Joey9801/Lynx/README

Lynx is an experimental radio transmitter for HAB's
