Joey9801/Lynx/Lynx PCB r1/Lynx.brd

## EAGLE design Lynx PCB r1/Lynx.brd (2013-07-16)

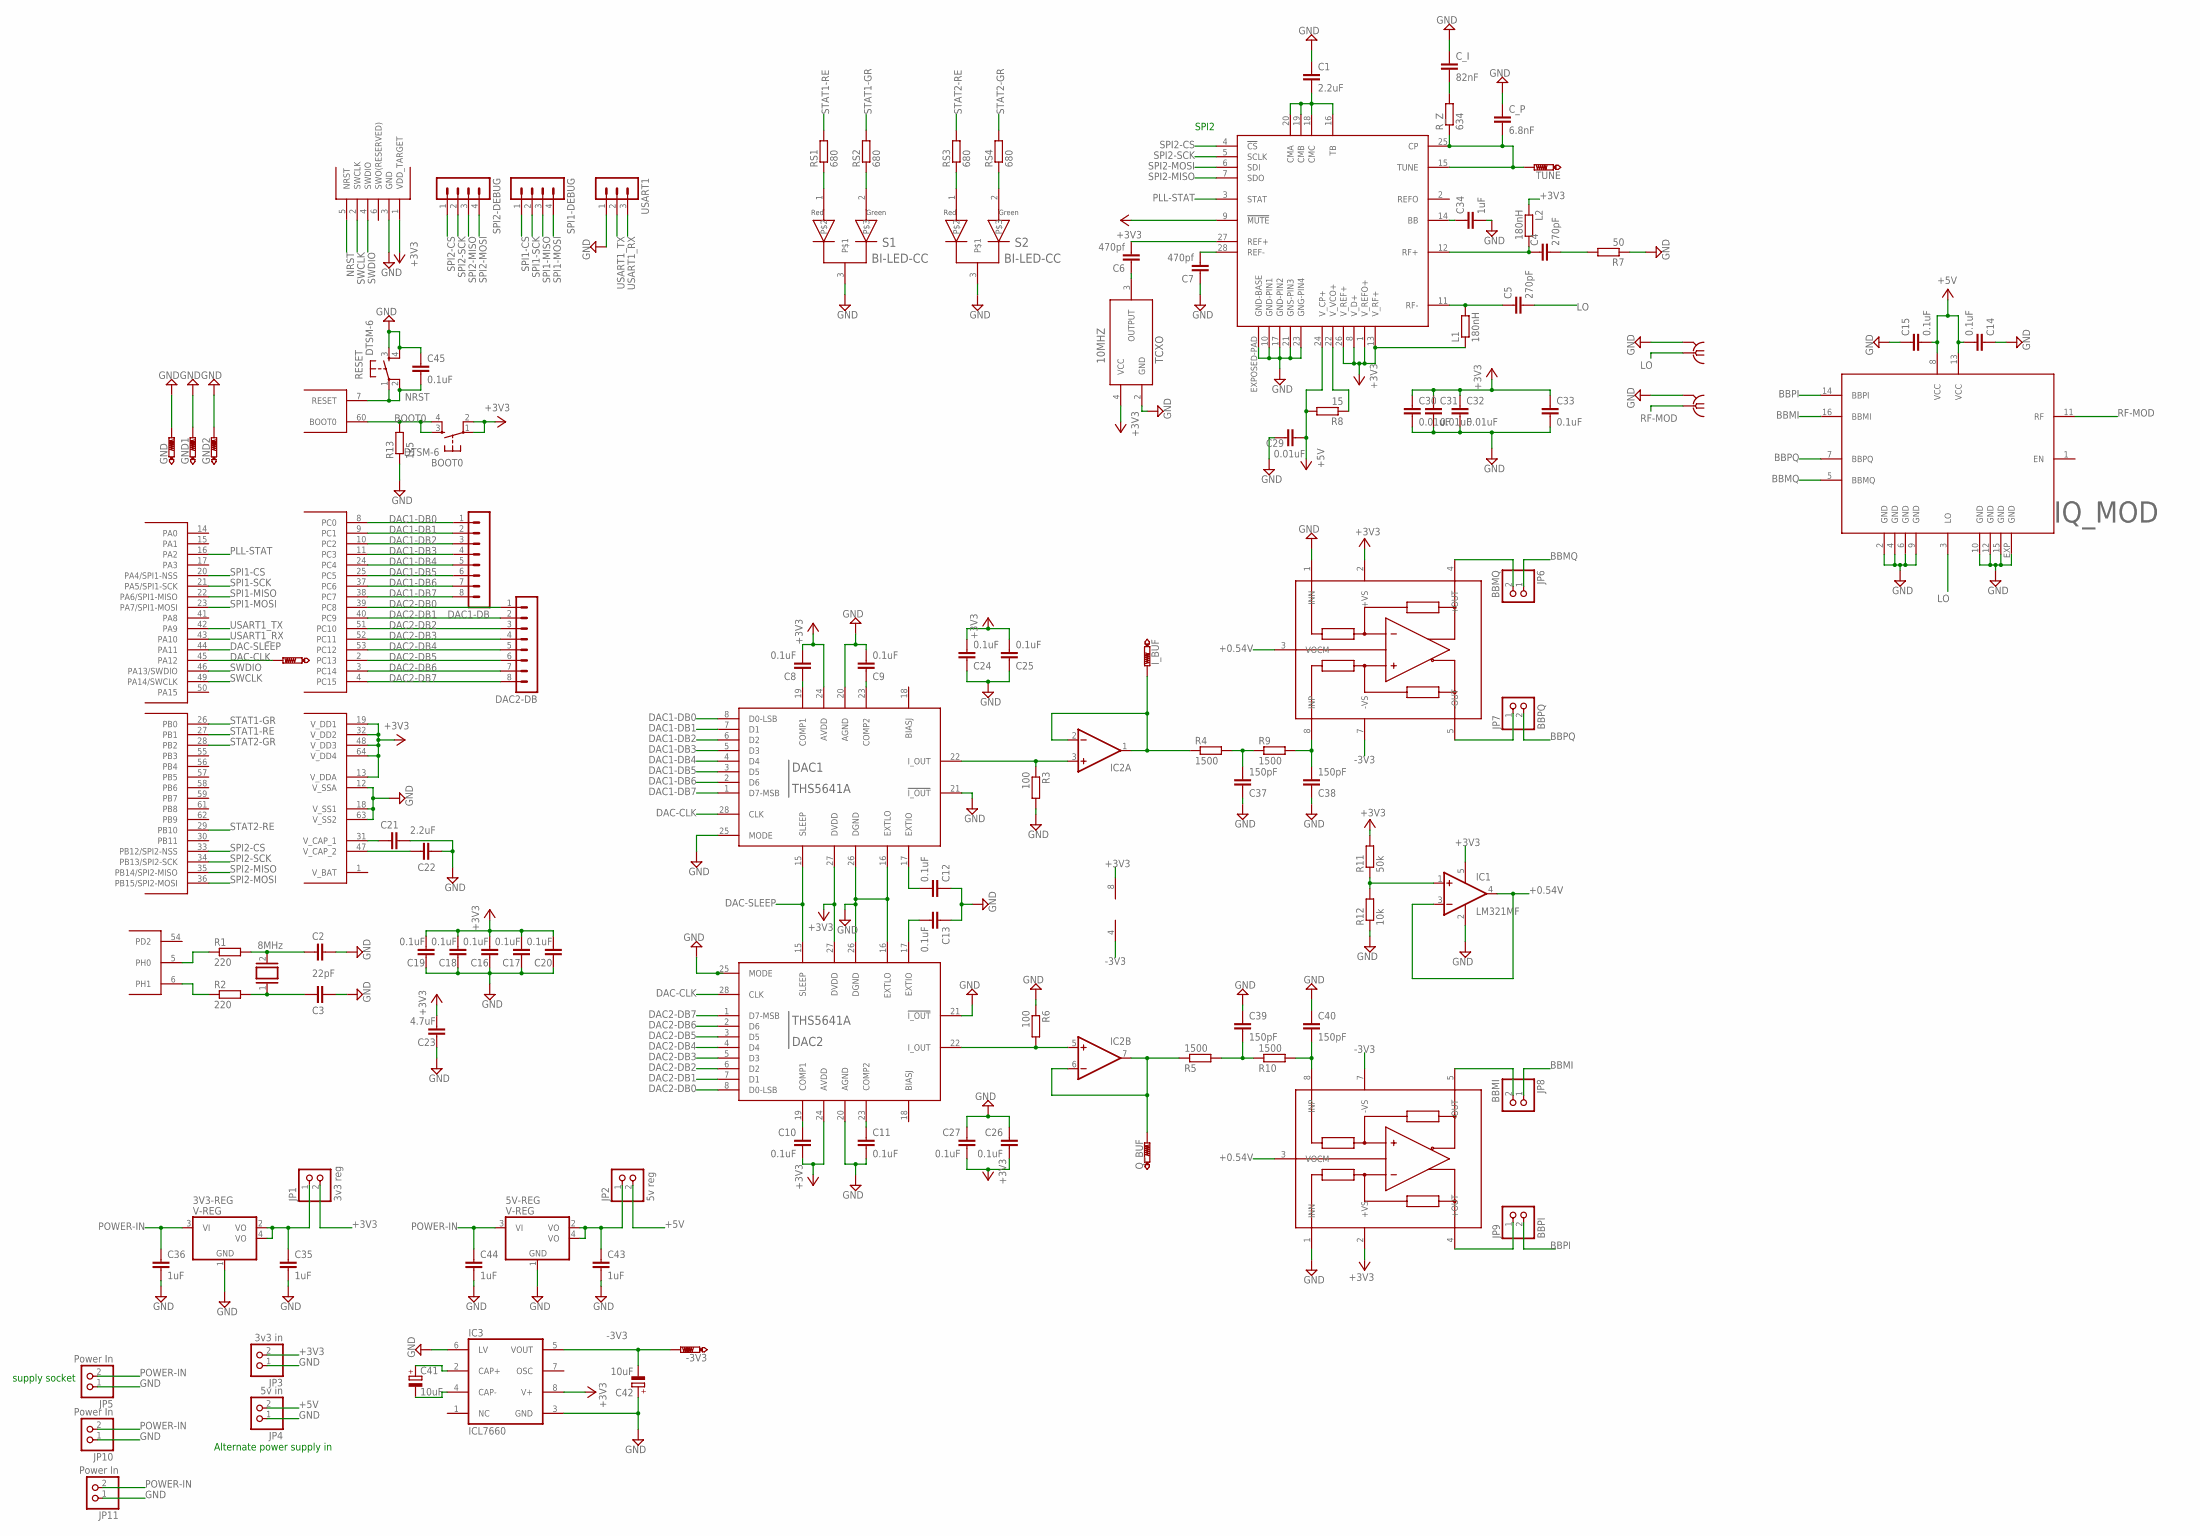
[picture p1: schematic Lynx.sch]

Parts:
3V3-REG, 5V-REG: V-REG; SOT223
10MHZ: TCXO; TXCO5.6
-3V3: PTR1PAD1-13Y; P1-13Y
BOOT0: DTSM-6
C1, C21, C22: 2.2uF; C0603
C2, C3: 22pF; C0603
C4, C5: 270pF; C0805
C6, C7: 470pf; C0402
C8, C9, C10, C11, C12, C13, C14, C15, C16, C17, C18, C19, C20, C24, C25, C26, C27, C33, C45: 0.1uF; C0603
C23: 4.7uF; C0603
C29, C30, C32: 0.01uF; C0603
C31: 0.01uF; C0402
C34, C35, C36, C43, C44: 1uF; C0603
C37, C38, C39, C40: 150pF; C0603
C41, C42: 10uF; SANYO-OSCON_SMD_B6
C_I: 82nF; C1210
C_P: 6.8nF; C0805
DAC1, DAC2: THS5641A; SO28
DAC1-DB, DAC2-DB: MA08-1
DAC-CLK: PTR1PAD1-13Y; P1-13Y
GND, GND1, GND2: PTR1PAD1-13Y; P1-13Y
IC1: LM321MF; SOT23-5
IC2: 2AMP_P8+4D; SO08
IC3: ICL7660; SO08
IQ_MOD: LT5568; QFN-16
I_BUF: PTR1PAD1-13Y; P1-13Y
JP1: 3v3 reg; 1X02
JP2: 5v reg; 1X02
JP3: 3v3 in; 1X02
JP4: 5v in; 1X02
JP5, JP10, JP11: Power In; 1X02
JP6: BBMQ; 1X02
JP7: BBPQ; 1X02
JP8: BBMI; 1X02
JP9: BBPI; 1X02
L1, L2: 180nH; R0402
LO: SMA-142-0711-821/826; J502-ND-142-0711-821/826
Q1: 8MHz; QS
Q_BUF: PTR1PAD1-13Y; P1-13Y
R1, R2: 220; R0603
R3, R6: 100; R0603
R4, R5, R9, R10: 1500; R0603
R7: 50; R0805
R8: 15; R0603
R11: 50k; R0603
R12: 10k; R0603
R13: 1k5; R0603
RESET: DTSM-6
RF-MOD: SMA-142-0711-821/826; J502-ND-142-0711-821/826
RS1, RS2, RS3, RS4: 680; R0603
R_Z: 634; R0805
S1, S2: BI-LED-CC; SOT-23
SPI1-DEBUG, SPI2-DEBUG: MA04-1
SWD-HEADER: SWD-HEADER; 6PIN-HEADER
TUNE: PTR1B1,27; B1,27
U$1: STM32F415RGT6; LQFP-64
U$3: LTC6946; QFN-28
U$4, U$5: AD8476; MSOP8
USART1: MA03-1

Connections:
5V-REG: 5V-REG.2 (VO), 5V-REG.4 (VO), C43.1, JP2.1
+0.54V: IC1.3 (-IN), IC1.4 (OUT), U$4.3 (VOCM), U$5.3 (VOCM)
+3V3: 10MHZ.4 (VCC), BOOT0.1, BOOT0.2, C8.2, C10.2, C16.2, C17.2, C18.2, C19.2, C20.2, C23.2, C24.2, C25.2, C26.2, C27.2, C30.1, C31.1, C32.1, C33.1, DAC1.24 (AVDD), DAC1.27 (DVDD), DAC2.24 (AVDD), DAC2.27 (DVDD), IC1.5 (V+), IC2.8 (V+), IC3.8 (V+), JP1.2, JP3.2, L1.1, L2.1, R11.2, SWD-HEADER.1 (VDD_TARGET), U$1.13 (V_DDA), U$1.19 (V_DD1), U$1.32 (V_DD2), U$1.48 (V_DD3), U$1.64 (V_DD4), U$3.1 (V_REFO+), U$3.8 (V_D+), U$3.9 (!MUTE!), U$3.13 (V_RF+), U$3.26 (V_REF+), U$4.2 (+VS), U$5.2 (+VS)
+5V: C14.2, C15.2, C29.2, IQ_MOD.8 (VCC), IQ_MOD.13 (VCC), JP2.2, JP4.2, R8.2, U$3.24 (V_CP+)
-3V3: -3V3.TP, C42.-, IC2.4 (V-), IC3.5 (VOUT), U$4.7 (-VS), U$5.7 (-VS)
BBMI: IQ_MOD.16 (BBMI), JP8.1
BBMQ: IQ_MOD.5 (BBMQ), JP6.1
BBPI: IQ_MOD.14 (BBPI), JP9.2
BBPQ: IQ_MOD.7 (BBPQ), JP7.2
BOOT0: BOOT0.3, BOOT0.4, R13.2, U$1.60 (BOOT0)
DAC1-DB0: DAC1.8 (D0-LSB), DAC1-DB.1, U$1.8 (PC0)
DAC1-DB1: DAC1.7 (D1), DAC1-DB.2, U$1.9 (PC1)
DAC1-DB2: DAC1.6 (D2), DAC1-DB.3, U$1.10 (PC2)
DAC1-DB3: DAC1.5 (D3), DAC1-DB.4, U$1.11 (PC3)
DAC1-DB4: DAC1.4 (D4), DAC1-DB.5, U$1.24 (PC4)
DAC1-DB5: DAC1.3 (D5), DAC1-DB.6, U$1.25 (PC5)
DAC1-DB6: DAC1.2 (D6), DAC1-DB.7, U$1.37 (PC6)
DAC1-DB7: DAC1.1 (D7-MSB), DAC1-DB.8, U$1.38 (PC7)
DAC2-DB0: DAC2.8 (D0-LSB), DAC2-DB.1, U$1.39 (PC8)
DAC2-DB1: DAC2.7 (D1), DAC2-DB.2, U$1.40 (PC9)
DAC2-DB2: DAC2.6 (D2), DAC2-DB.3, U$1.51 (PC10)
DAC2-DB3: DAC2.5 (D3), DAC2-DB.4, U$1.52 (PC11)
DAC2-DB4: DAC2.4 (D4), DAC2-DB.5, U$1.53 (PC12)
DAC2-DB5: DAC2.3 (D5), DAC2-DB.6, U$1.2 (PC13)
DAC2-DB6: DAC2.2 (D6), DAC2-DB.7, U$1.3 (PC14)
DAC2-DB7: DAC2.1 (D7-MSB), DAC2-DB.8, U$1.4 (PC15)
DAC-CLK: DAC1.28 (CLK), DAC2.28 (CLK), DAC-CLK.TP, U$1.45 (PA12)
DAC-SLEEP: DAC1.15 (SLEEP), DAC2.15 (SLEEP), U$1.44 (PA11)
GND: 3V3-REG.1 (GND), 5V-REG.1 (GND), 10MHZ.2 (GND), C1.1, C2.2, C3.2, C7.1, C9.2, C11.2, C12.1, C13.1, C14.1, C15.1, C16.1, C17.1, C18.1, C19.1, C20.1, C21.2, C22.2, C23.1, C24.1, C25.1, C26.1, C27.1, C29.1, C30.2, C31.2, C32.2, C33.2, C34.2, C35.2, C36.2, C37.1, C38.1, C39.1, C40.1, C42.+, C43.2, C44.2, C45.1, C_I.1, C_P.1, DAC1.16 (EXTLO), DAC1.20 (AGND), DAC1.21 (!I_OUT!), DAC1.25 (MODE), DAC1.26 (DGND), DAC2.16 (EXTLO), DAC2.20 (AGND), DAC2.21 (!I_OUT!), DAC2.25 (MODE), DAC2.26 (DGND), GND.TP, GND1.TP, GND2.TP, IC1.2 (V-), IC3.3 (GND), IC3.6 (LV), IQ_MOD.2 (GND), IQ_MOD.4 (GND), IQ_MOD.6 (GND), IQ_MOD.9 (GND), IQ_MOD.10 (GND), IQ_MOD.12 (GND), IQ_MOD.15 (GND), IQ_MOD.EXP (GND), JP3.1, JP4.1, JP5.1, JP10.1, JP11.1, LO.G@1 (2), LO.G@2 (2), LO.G@3 (2), LO.G@4 (2), R3.2, R6.1, R7.1, R12.1, R13.1, RESET.3, RESET.4, RF-MOD.G@1 (2), RF-MOD.G@2 (2), RF-MOD.G@3 (2), RF-MOD.G@4 (2), S1.3, S2.3, SWD-HEADER.3 (GND), U$1.12 (V_SSA), U$1.18 (V_SS1), U$1.63 (V_SS2), U$3.10 (GND-PIN1), U$3.17 (GND-PIN2), U$3.21 (GNS-PIN3), U$3.23 (GNG-PIN4), U$3.EXPOSED-PAD (GND-BASE), U$4.1 (INN), U$5.1 (INN), USART1.1
I_BUF: IC2.1 (OUT), IC2.2 (-IN), I_BUF.TP, R4.1
LO: C5.2, IQ_MOD.3 (LO), LO.1
unnamed: C_P.2, R_Z.1, TUNE.TP, U$3.15 (TUNE), U$3.25 (CP)
unnamed: C1.2, U$3.16 (TB), U$3.18 (CMC), U$3.19 (CMB), U$3.20 (CMA)
unnamed: C7.2, U$3.28 (REF-)
unnamed: C3.1, Q1.1, R2.2
unnamed: C2.1, Q1.2, R1.2
unnamed: R1.1, U$1.5 (PH0)
unnamed: R2.1, U$1.6 (PH1)
unnamed: C5.1, L1.2, U$3.11 (RF-)
unnamed: C4.2, R7.2
unnamed: C13.2, DAC2.17 (EXTIO)
unnamed: C8.1, DAC1.19 (COMP1)
unnamed: C12.2, DAC1.17 (EXTIO)
unnamed: DAC1.22 (I_OUT), IC2.3 (+IN), R3.1
unnamed: JP6.2, U$4.4 (+OUT)
unnamed: RS1.1, S1.1
unnamed: RS2.1, S1.2
unnamed: RS3.1, S2.1
unnamed: RS4.1, S2.2
unnamed: C10.1, DAC2.19 (COMP1)
unnamed: C6.2, U$3.27 (REF+)
unnamed: 10MHZ.3 (OUTPUT), C6.1
unnamed: C_I.2, R_Z.2
unnamed: C9.1, DAC1.23 (COMP2)
unnamed: C11.1, DAC2.23 (COMP2)
unnamed: C21.1, U$1.31 (V_CAP_1)
unnamed: C22.1, U$1.47 (V_CAP_2)
unnamed: JP7.1, U$4.5 (-OUT)
unnamed: DAC2.22 (I_OUT), IC2.5 (+IN), R6.2
unnamed: R8.1, U$3.22 (V_VCO+)
unnamed: C37.2, R4.2, R9.1
unnamed: C38.2, R9.2, U$4.8 (INP)
unnamed: C34.1, U$3.14 (BB)
unnamed: C41.-, IC3.4 (CAP-)
unnamed: C39.2, R5.2, R10.1
unnamed: C40.2, R10.2, U$5.8 (INP)
unnamed: C41.+, IC3.2 (CAP+)
unnamed: 3V3-REG.2 (VO), 3V3-REG.4 (VO), C35.1, JP1.1
unnamed: JP8.2, U$5.5 (-OUT)
unnamed: JP9.1, U$5.4 (+OUT)
unnamed: IC1.1 (+IN), R11.1, R12.2
NRST: C45.2, RESET.1, RESET.2, SWD-HEADER.5 (NRST), U$1.7 (RESET)
PLL-STAT: U$1.16 (PA2), U$3.3 (STAT)
POWER-IN: 3V3-REG.3 (VI), 5V-REG.3 (VI), C36.1, C44.1, JP5.2, JP10.2, JP11.2
Q_BUF: IC2.6 (-IN), IC2.7 (OUT), Q_BUF.TP, R5.1
RF+: C4.1, L2.2, U$3.12 (RF+)
RF-MOD: IQ_MOD.11 (RF), RF-MOD.1
SPI1-CS: SPI1-DEBUG.1, U$1.20 (PA4/SPI1-NSS)
SPI1-MISO: SPI1-DEBUG.3, U$1.22 (PA6/SPI1-MISO)
SPI1-MOSI: SPI1-DEBUG.4, U$1.23 (PA7/SPI1-MOSI)
SPI1-SCK: SPI1-DEBUG.2, U$1.21 (PA5/SPI1-SCK)
SPI2-CS: SPI2-DEBUG.1, U$1.33 (PB12/SPI2-NSS), U$3.4 (!CS!)
SPI2-MISO: SPI2-DEBUG.3, U$1.35 (PB14/SPI2-MISO), U$3.7 (SDO)
SPI2-MOSI: SPI2-DEBUG.4, U$1.36 (PB15/SPI2-MOSI), U$3.6 (SDI)
SPI2-SCK: SPI2-DEBUG.2, U$1.34 (PB13/SPI2-SCK), U$3.5 (SCLK)
STAT1-GR: RS2.2, U$1.26 (PB0)
STAT1-RE: RS1.2, U$1.27 (PB1)
STAT2-GR: RS4.2, U$1.28 (PB2)
STAT2-RE: RS3.2, U$1.29 (PB10)
SWCLK: SWD-HEADER.2 (SWCLK), U$1.49 (PA14/SWCLK)
SWDIO: SWD-HEADER.4 (SWDIO), U$1.46 (PA13/SWDIO)
USART1_RX: U$1.43 (PA10), USART1.3
USART1_TX: U$1.42 (PA9), USART1.2

Notes on the sheet:
Alternate power supply in
supply socket
SPI2

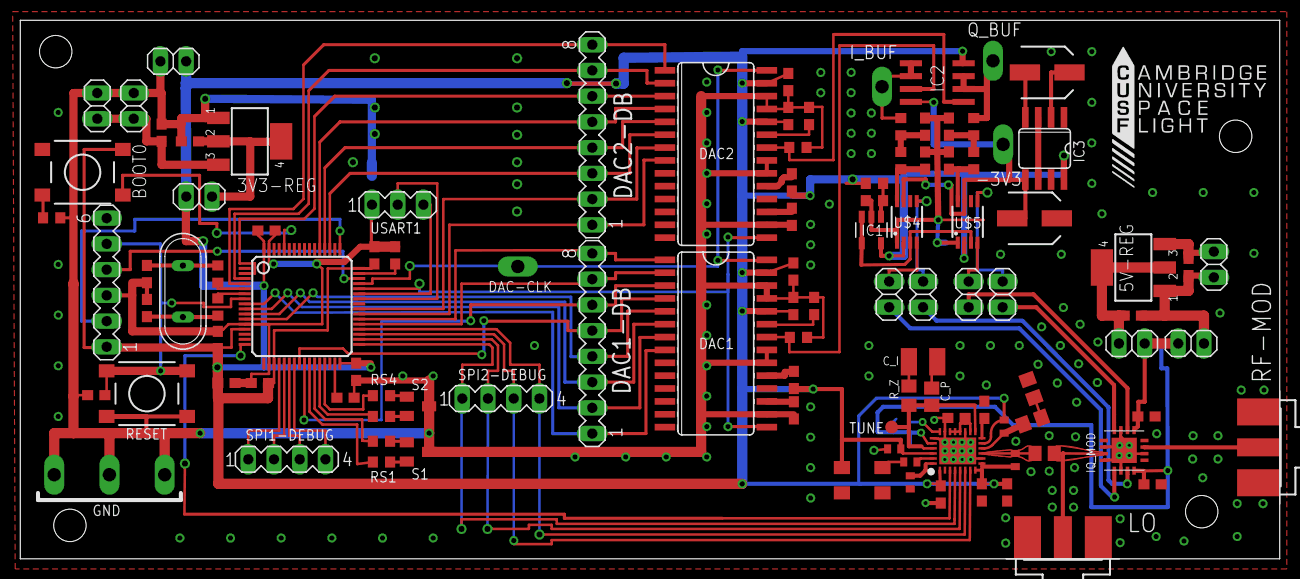
[picture p2: board Lynx.brd from above]

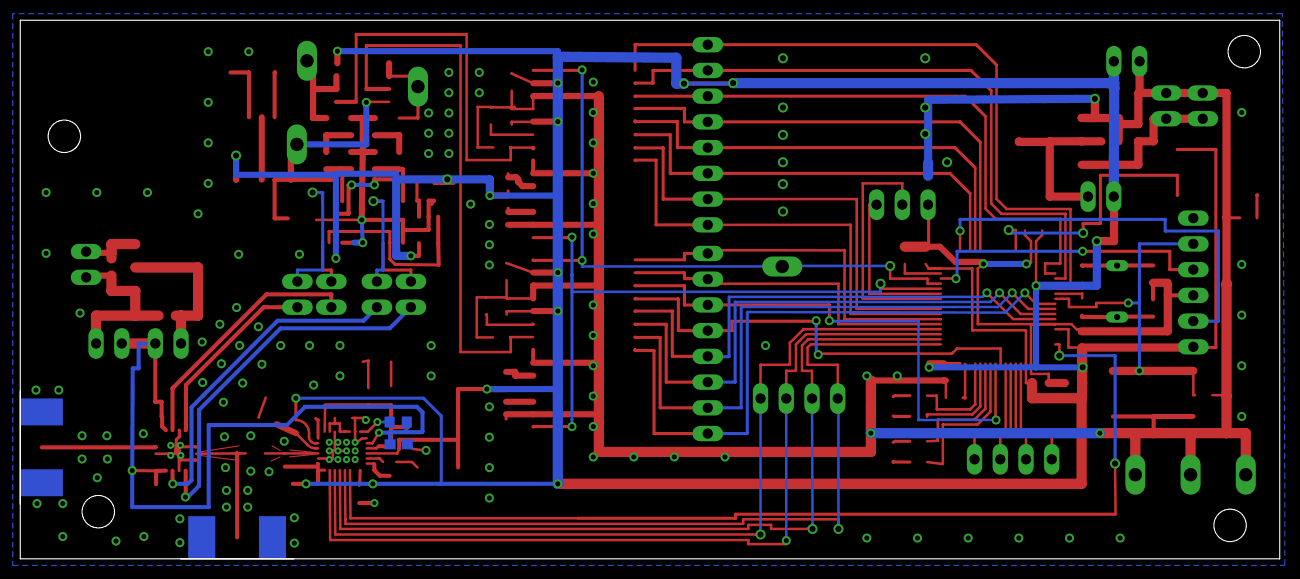
[picture p3: board Lynx.brd from below]

Board: 2 copper layers, 124.3 x 53.1 mm, 112 parts (2 on the bottom side), 93 nets.

Other parts of the board:
U$2: CUSF_LOGO
