Joey9801/Lynx/playground/init.c

#include "init.h"

static void clock_setup(void){
	/*Operate at 168MHz*/
	rcc_clock_setup_hse_3v3(&hse_8mhz_3v3[CLOCK_3V3_168MHZ]);

	//usart2
	rcc_peripheral_enable_clock(&RCC_APB1ENR, RCC_APB1ENR_USART2EN);

	//usart port
	rcc_peripheral_enable_clock(&RCC_AHB1ENR, RCC_AHB1ENR_IOPAEN);

	//led port
	rcc_peripheral_enable_clock(&RCC_AHB1ENR, RCC_AHB1ENR_IOPDEN);

	//SPI1
	rcc_peripheral_enable_clock(&RCC_APB2ENR, RCC_APB2ENR_SPI1EN);
	
	//SPI1 port
	rcc_peripheral_enable_clock(&RCC_AHB1ENR, RCC_AHB1ENR_IOPAEN);

	//Accelerometer CS port
	rcc_peripheral_enable_clock(&RCC_AHB1ENR, RCC_AHB1ENR_IOPEEN);
}

static void usart_setup(void){
	/* set the baudrate
	set the data and stop bits
	set the mode (tx/rx etc)
	set parity bits
	set flow control - may not apply for uart
	enable the thing */

	//usart pins
	gpio_mode_setup(GPIOA, GPIO_MODE_AF, GPIO_PUPD_NONE,
						GPIO2|
						GPIO3);
	gpio_set_af(GPIOA, GPIO_AF7,		GPIO2|
						GPIO3);

	usart_set_baudrate(USART2, 38400);
	usart_set_databits(USART2, 8);
	usart_set_stopbits(USART2, USART_STOPBITS_1);
	usart_set_mode(USART2, USART_MODE_TX);
	usart_set_parity(USART2, USART_PARITY_NONE);
	usart_set_flow_control(USART2, USART_FLOWCONTROL_NONE);

	usart_enable(USART2);
}


static void spi_setup(void){

//PA5 -> SPI1 SCK
//PA6 -> SPI1 MISO
//PA7 -> SPI1 MOSI
//PE3 -> Accel CS

	/*initialise PE3 for CS*/
	gpio_mode_setup(GPIOE, GPIO_MODE_OUTPUT, GPIO_PUPD_NONE, GPIO3);
	gpio_set(GPIOE, GPIO3); //deselect the accelerometer
	
	/*Initialise SPI1 pins for AF*/
	gpio_mode_setup(GPIOA, GPIO_MODE_AF, GPIO_PUPD_NONE, GPIO5|GPIO6|GPIO7);
	gpio_set_af(GPIOA, GPIO_AF5, GPIO5|GPIO6|GPIO7);
	
	spi_init_master(SPI1, SPI_CR1_BAUDRATE_FPCLK_DIV_32,
			/* high or low for the peripheral device */
			SPI_CR1_CPOL_CLK_TO_1_WHEN_IDLE,
			/* CPHA: Clock phase: read on rising edge of clock */
			SPI_CR1_CPHA_CLK_TRANSITION_2,
			/* DFF: Date frame format (8 or 16 bit) */
			SPI_CR1_DFF_8BIT,
			/* Most or Least Sig Bit First */
			SPI_CR1_MSBFIRST);

	spi_enable_software_slave_management(SPI1);
	spi_set_nss_high(SPI1);


	//enable SPI1
	spi_enable(SPI1);

	//spi_enable_software_slave_management(SPI1);
	//spi_set_nss_high(SPI1);
	
}


static void gpio_setup(void){
	//setup the led pins
	rcc_peripheral_enable_clock(&RCC_AHB1ENR, RCC_AHB1ENR_IOPDEN);
	gpio_mode_setup(GPIOD, GPIO_MODE_OUTPUT, GPIO_PUPD_NONE, 
						GPIO12| 
						GPIO13| 
						GPIO14| 
						GPIO15);
	
}

void accel_setup(void){
	char command =
	    /* data rate selection, 1 = 400Hz */
	    (0x1 << 7) |
	    /* power down control, 1 = active */
	    (0x1 << 6) |
	    /* full scale selection (1 = 8G, 0 = 2G) */
	    (0x0 << 5) |
	    /* Z axis enable */
	    (0x1 << 2) |
	    /* Y axis enable */
	    (0x1 << 1) |
	    /* X axis enable */
	    (0x1 << 0);
	gpio_clear(GPIOE, GPIO3);
	spi_send(SPI1, 0x20);		//control register address
	spi_send(SPI1, command);	//control bits
	while(SPI_SR(SPI1)&SPI_SR_BSY);
	gpio_set(GPIOE, GPIO3);
}
