Joey9801/Lynx/(commit log)

2013-07-02 init prototypes
2013-07-05 PCB r1 wip
    [Lynx.brd, Lynx.sch, Schematic.brd, Schematic.sch]
2013-07-05 Revert "PCB r1 wip"
    This reverts commit 15770d55321f7ac96c8f35ec2526d0d9f5ee7b52.
    [Lynx.brd, Lynx.sch, Schematic.brd, Schematic.sch]
2013-07-05 pcb commit (no fail this time)
    [Lynx.brd, Lynx.sch, Schematic.brd, Schematic.sch]
2013-07-05 PCB WIP
    [Lynx.brd, Lynx.sch]
2013-07-10 rf routing
    [Lynx.brd, Lynx.sch]
2013-07-10 made the spi work woop woop
2013-07-11 Power supply and jumpers
    So many jumpers
    [Lynx.brd, Lynx.sch]
2013-07-11 tidy up
    [Schematic.brd, Schematic.sch]
2013-07-11 more tidy up
    [Schematic.brd, Schematic.sch]
2013-07-12 Complete rf reroute
    Shuffled a 'lot' of things around. Ripped up everything past the op-amps
    and made it a lot nicer.
    [Lynx.brd, Lynx.sch]
2013-07-12 All routed
    [Lynx.brd, Lynx.sch]
2013-07-12 Added 0.54v reference souce, made DRC happy
    [Lynx.brd, Lynx.sch]
2013-07-12 Description text, pll-stat line
    [Lynx.brd, Lynx.sch]
2013-07-12 started sorting out the silkscreen
    [Lynx.brd, Lynx.sch]
2013-07-12 more silk
    [Lynx.brd]
2013-07-14 Finished first pass of silk
    Finished organizing the first revision of the artwork. Added pin names
    to all busses. Created a dac-clk test pin
    [Lynx.brd, Lynx.sch]
2013-07-15 Changes as per Cillian
    Changed the layout of the RF
    swapped out the coax connectors
    added "TUNE" test point
    revamped the ground planes
    stitched the ground planes (a lot)
    [Lynx.brd, Lynx.sch]
2013-07-16 Final PCB r1 commit
    Fixed lots of little thing.
    Gerbers checked
    Fixed 0.54v generation oopsie (inverting and non-inverting terminals
    wrong way around)
    [Lynx.brd, Lynx.sch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]
2013-07-16 What was send to the board house
    [Lynx.brd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]
2013-07-17 all init prototypes, main loop
2013-07-18 fixed silly things, now compiles
    [constellation.h, ecc.c, lynx.c, lynx.h]
2013-07-18 timer sheduling tests
2013-07-19 lots of sheduling, timers configured
2013-07-19 fixed transmit hang in main todo loop
    [lynx.c]
2013-07-19 setup TIM5 as function timer
2013-07-26 fixed error in usart_setup()
    [setup.c]
2013-07-26 swapped 'status' out for set of bools
    [lynx.c, lynx.h]
